ajvdw/PeakShaver/Media/PrototypePCB.jpg

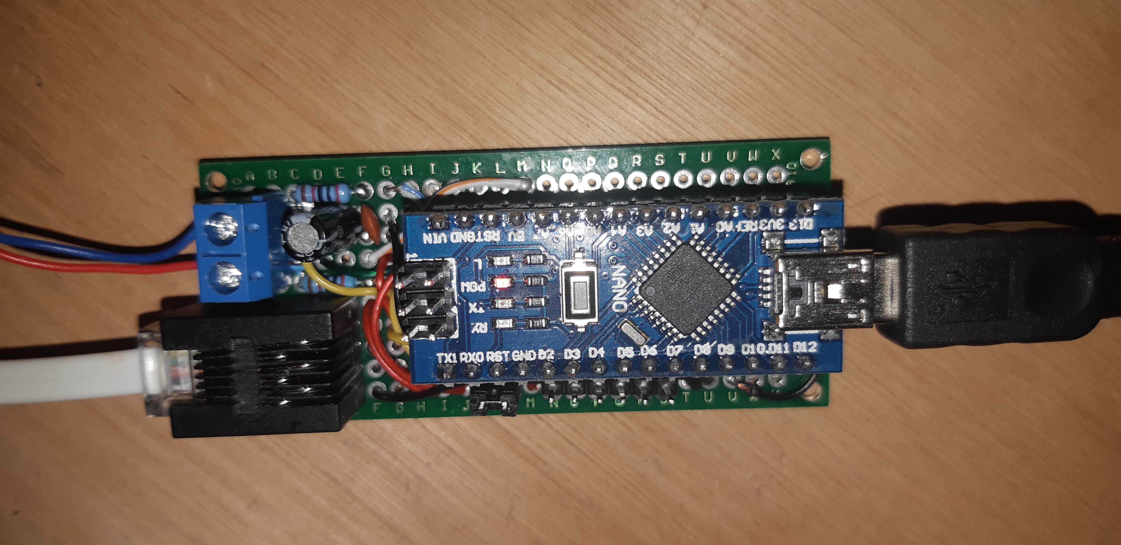
Media/PrototypePCB.jpg
