ajvdw/PeakShaver/README.md

# PeakShaver

Limit charging current for EV Charger using Smart Meter Data
