ajvdw/PeakShaver/Media/EnergyMonitor.png

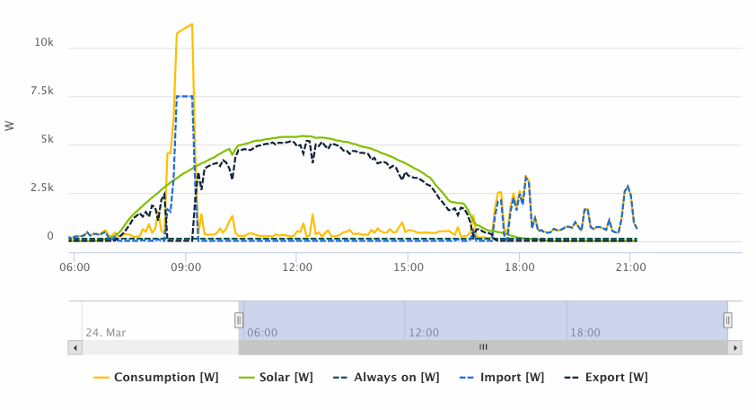
Media/EnergyMonitor.png
