ajvdw/PeakShaver/Media/PeakShaver.pdf

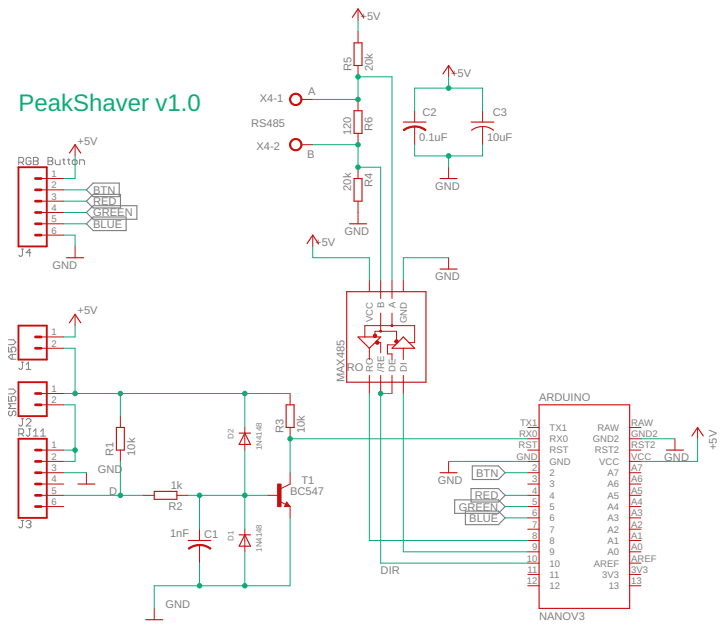
[picture p3: page 1]
