ajvdw/PeakShaver/Eagle/PeakShaver.brd

## EAGLE design Eagle/PeakShaver.brd (2020-04-19)

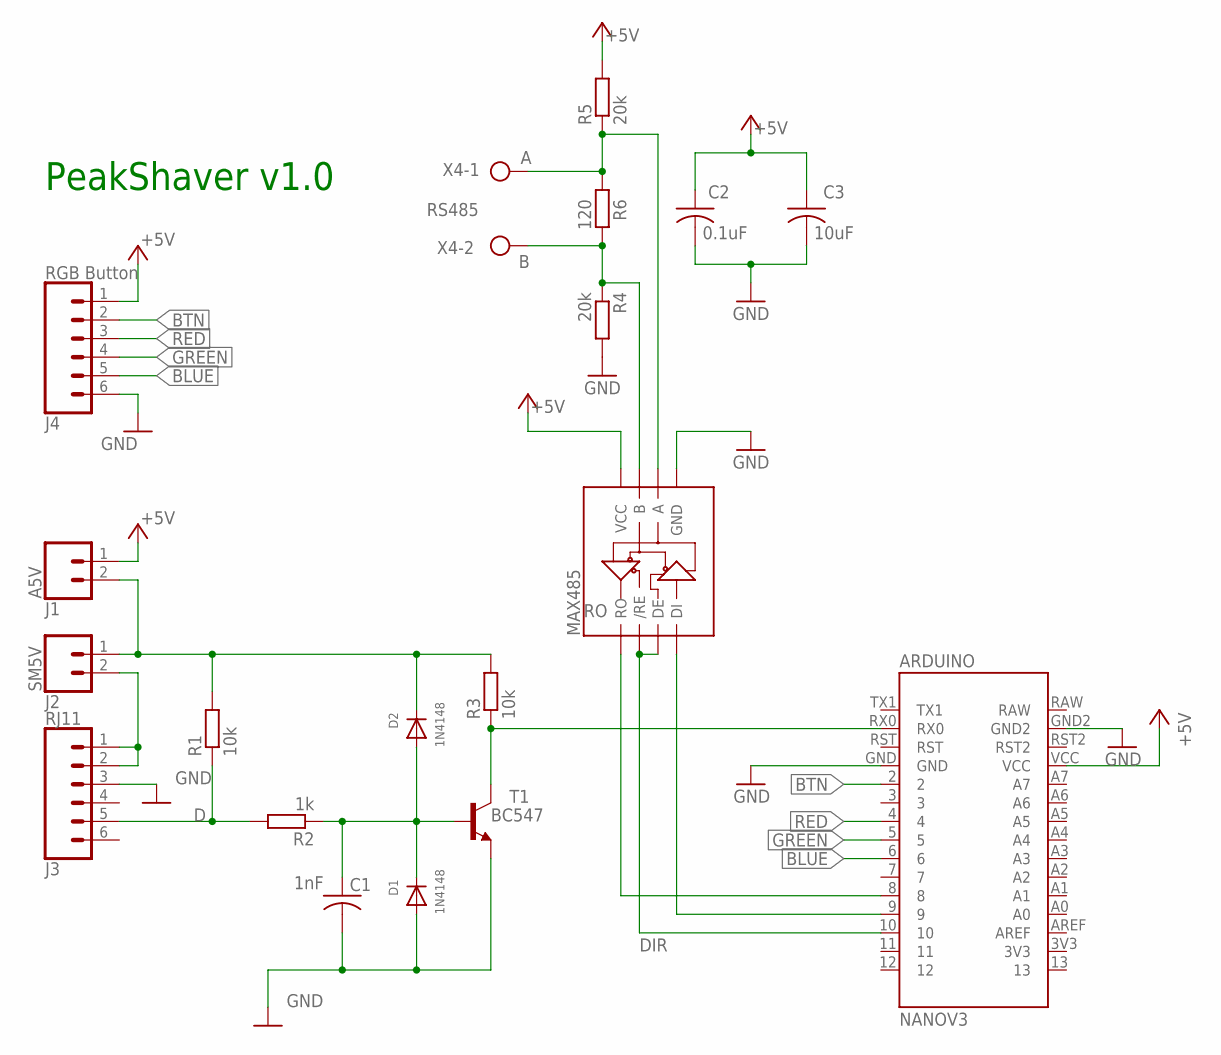
[picture p4: schematic PeakShaver.sch]

Parts:
ARDUINO: NANOV3
C1: 1nF; C025-025X050
C2: 0.1uF; C025-025X050
C3: 10uF; CAP_RADIAL_2MM
D1, D2: 1N4148; DO-1N4148
J1: A5V; 1X02
J2: SM5V; 1X02
J3: RJ11; RJ11-6
J4: RGB Button; 1X06_LOCK
MAX485: SPARKFUN-IC-COMMS_RS485; TEXAS_DIL08
R1, R3: 10k; 0207/10
R2: 1k; 0207/10
R4, R5: 20k; 0207/10
R6: 120; 0207/10
T1: BC547; TO92
X4: RS485; W237-102

Connections:
+5V: ARDUINO.VCC, C2.1, C3.1, J1.1, J4.1, MAX485.8 (VCC), R5.2
A: MAX485.6 (A), R5.1, R6.1, X4.1
B: MAX485.7 (B), R4.1, R6.2, X4.2
BASE: C1.1, D1.C, D2.A, R2.1, T1.2 (B)
BLUE: ARDUINO.6, J4.5
BTN: ARDUINO.2, J4.2
D: J3.5, R1.1, R2.2
DI: ARDUINO.9, MAX485.4 (DI)
DIR: ARDUINO.10, MAX485.2 (/RE), MAX485.3 (DE)
GND: ARDUINO.GND, ARDUINO.GND2, C1.2, C2.2, C3.2, D1.A, J3.3, J4.6, MAX485.5 (GND), R4.2, T1.1 (E)
GREEN: ARDUINO.5, J4.4
unnamed: D2.C, J1.2, J2.1, R1.2, R3.2
RED: ARDUINO.4, J4.3
RO: ARDUINO.8, MAX485.1 (RO)
RTS: J2.2, J3.1, J3.2
RX: ARDUINO.RX0, R3.1, T1.3 (C)

Notes on the sheet:
PeakShaver v1.0

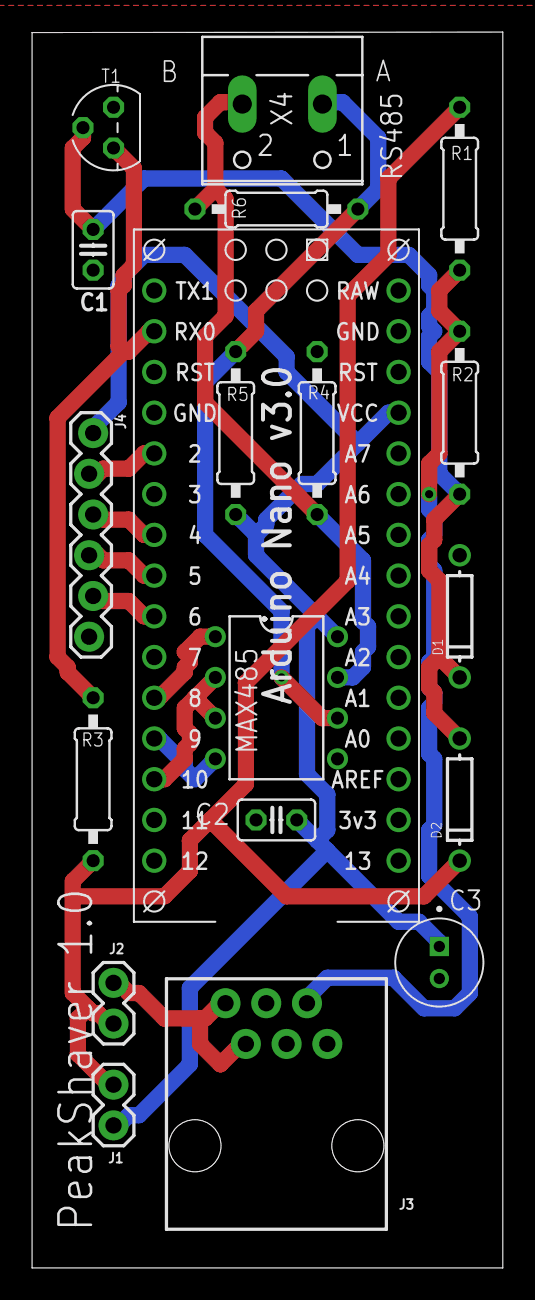
[picture p5: board PeakShaver.brd from above]

Board: 2 copper layers, 29.4 x 77.1 mm, 19 parts (0 on the bottom side), 16 nets.
