ajvdw/PeakShaver/(commit log)

2020-03-24 Added Media
    [PeakShaver.sch]
2020-04-19 fixed bug in P1 connection
    P1 ground and data line were swapped in version 0.9
    [PeakShaver.brd, PeakShaver.sch]
2020-04-27 Minor changes
    [PeakShaver.brd, PeakShaver.sch]
